giladnahor/PVCdidge/(commit log)

2026-04-25 Initial commit: PVCdidge v1.0
    Parametric OpenSCAD didgeridoo mouthpiece for standard PVC pipe.
    Snap-fits onto 40 mm DIN, 50 mm DIN, or 1.5" Schedule 40 PVC.
    Acoustically tuned per UNSW didgeridoo physics research, with
    asymmetric rim, internal taper, and bore-wall reinforcement slit.
    [didgeridooMouthpiece.scad]
2026-04-25 Add RESEARCH.md with annotated bibliography
    Captures the player research, UNSW Wolfe acoustics paper, slicer
    gap-closing-radius technique, materials comparison, and existing
    3D-printed designs that informed v1.0's geometry decisions. Future
    parameter changes should consult this document for rationale.
    Cross-linked from README and CLAUDE.md.
2026-04-25 Add print-on-demand store link to README
2026-05-21 Add bell-end model: exponential flare, snap-fits on PVC pipe
    New `didgeridooBellEnd.scad` mirrors the mouthpiece's three-piece
    cross-section pattern (feature piece + inner insert + outer sleeve) with
    the same pipe-joint geometry and slicer-fill slit trick. Bell body is a
    dual-exponential flare from pipe ID up to a 105 mm rim, with a rolled
    rim fillet and a base that thickens for bed adhesion.
    Acoustic basis added to RESEARCH.md §1: Webster horn equation, exponen-
    tial vs. cone vs. tractrix junction discontinuities (the exponential's
    kink is smaller than a cone's but not zero), and the Levine-Schwinger
    end correction. README and CLAUDE.md updated to reflect the two-part
    design.
    Design spec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
    [didgeridooBellEnd.scad]
